JMarlin/nesii/(threads)

Thread 14 (2024-07-19):

[NES II] Add disk read timeout to bios

JMarlin, 2024-07-19:
## Description

As a user of the NES ][ it would be nice if the system were able to time out and drop to the monitor if there's no disk inserted

## Acceptance criteria

- [x] Sector read code sets a failure flag and exits in all the following cases rather than retrying forever
    - [x] Checksum mismatch
    - [x] Track mismatch
- [x] ~Sector read code includes a motor on and call to motor wait at entry which checks the return flag and uses it to fail exit early~
- [x] Motor wait call returns a failure flag and exits early in the following cases:
    - [x] Reading data latch never gets a high MSB after several reads
    - [x] Reading subsequent byte never changes after several reads
- [x] BIOS boot code retries boot sector load a couple of times and finally displays a message and drops into monitor
- [x] NOS boot is not broken
- [x] NOS DIR command is not broken
- [x] NOS RUN command is not broken
- [x] DONKEY is not broken

JMarlin, 2024-07-23:
Getting kind of frustrated with this, so here's the idea du jour: Forget the motor-on wait. Everywhere. Just base everything on retrying sector read

JMarlin, 2024-07-23:
Wrestling with flaky-ish hardware, but this looks like it's working properly now.
Got Mario to run with the current code which also handles the no-disk-at-boot condition properly, so it's functional.

I may want to add more retries to the binload routine in the future, though. And definitely will want to add proper failure handling to all of the fs and shell routines in the future.

Closed 2024-07-23.

Thread 22 (2024-07-26):

[NES II] Implement BIOS update module system

JMarlin, 2024-07-26:
## Description
In order to waste as little space as possible in our limited memory, I would like to harness the flexible memory mapping in the NES II cartridge to allow me to effectively add more system code to the BIOS area after boot in the form of binary overlays

## Acceptance criteria
- [x] PLD is updated to map high physical SRAM to low cart area in MODE 0 and map high physical SRAM to ROM area in MODE 2
- [x] BIOS immediately copies itself to high-RAM and then switches high-RAM into the BIOS area
- [x] ~~BIOS uses a flag in the ROM area to check whether it's already running out of RAM or not and not swap if it is~~
- [x] BIOS linking has been updated for efficiency so that it's not full of big useless holes
- [ ] DONKEY and MARIO loaders are updated to start in MODE 2 and switch to MODE 1 for second-half PRG load

JMarlin, 2024-07-26:
Important note: For some reason, it didn't occur to me that we still need to access the slot and switches when we're running the BIOS out of RAM. Figured out a hack wherein the high/low SRAM mapping is backwards from what it currently is between modes 0 and 2 and SRAM is selected in the ROM position in mode 2, but is otherwise the same. That way, when we start up in mode 0 we can copy the BIOS right into high physical SRAM and then switch into mode 2 running out of SRAM without really caring what physical portion of SRAM is mapped into the low cart area.

This is going to require some changes to both the PLD equations and the NES game loader code to work properly, which hasn't been implemented yet.

JMarlin, 2024-07-26:
Fixed up and tested the PLD to match the aforementioned scheme

JMarlin, 2024-07-26:
Note to myself about RAM availability: ostensibly, once we're in NOS, we can switch to one of the all-RAM modes and switch in and out of mode 2 when we need to do disk access. That should give us gobs of room for things like BASIC if we're going to end up wanting it.

Closed 2024-07-29.

Thread 23 (2024-07-26):

[NES II] Update SHELL to load any BIOS update modules found on the disk at startup

JMarlin, 2024-07-26:
## Description

For maximum flexibility and convenience, it would be nice to have update modules load themselves into the BIOS area simply by placing them on the disk. To that end, I would like the SHELL application to look through the catalog for update files and binary load each one before entering the command processor

## Acceptance criteria

- [ ] All bios update modules are loaded into the BIOS area when SHELL starts

JMarlin, 2024-08-07:
Making a note that I'm altering this radically. I've found that I can update the cart a little more to support RAM at 6000-7FFF and that obviates this whole module loading kerfuffle.

In the above commits, I've ended up moving the floppy space to E000, limiting the ROM to the FXXX area, and mapping the cart switches into that same FXXX space since they're write-only and the BIOS is read-only.

This gives me 8K (only 4K with the way I built the cart) of non-cart RAM that I can load NOS into, and also expands my non-game-mode cart RAM available for stuff like BASIC from 16K to 24K (now that the ROM+switches+floppy only occupy 8K of the cart area).

When it comes to BASIC, if I fix up the low RAM mapping so that I can use the full 8K then the extra nice thing is that in NESII mode I'll have an uninterrupted 32K of RAM stretching from 6000 to DFFF.

Actually, I could probably pretty trivially extend the non-cart RAM down to start at 5000 as well which would allow for 32K of RAM that can be FULLY dedicated to user purposes if I assume 4K of usage for NOS code

JMarlin, 2024-10-29:
After much heartache, I'm rolling back a bit here. The above approach just caused too many hardware headaches, so I'm moving back to the simpler method of compressing the address space (BIOS + switches @ 0xFXXX, slot @ 0xEXXX, RAM B @ 0xC000-0xDFFF)

I think I will keep the user module concept, and they will be loaded into the 0xC000-0xDFFF RAM.
As a note to myself, remember that the basic sector write code should be in the BIOS -- only the FS layer is in NOS (or, in the case of writes, TRON)

JMarlin, 2024-10-29:
And I should confirm that all hardware and software is tested and working as expected as of current main (commit f4df59a
)

JMarlin, 2025-02-28:
Back to it. The plan here is to once again provide an updatable BIOS situation.

At power-up, the BIOS should copy itself into $B000-$BFFF and then switch into 'swapped RAM' mode and continue execution. Swapped RAM mode should place what was at $Bxxx at $Fxxx (though still read-only).

When NOS starts up, it should swap back to 'original RAM' mode and then use the binloader to load any ".BUM" modules the normal way. These modules should be formatted to load into available slots in $Bxxx. Once all BUMs are loaded, NOS should switch back to 'swapped RAM' mode to lock in the BIOS changes.

BIOS changes can then include extended portions of NOS, such as the FS write implementation.

- [ ] RAM mapped read-only at $Fxxx in swapped-RAM mode
- [ ] BIOS copies itself into RAM at startup
- [ ] BIOS continues to execute from RAM
- [ ] NOS swaps RAM mapping, loads all BUMs, and swaps back at init

Thread 35 (2024-11-12):

[NES II] Select ROM only on CPU reads

JMarlin, 2024-11-12:
This is preparation for making writes to the same address space trigger the mode switches

JMarlin, 2024-11-12:
Tested against NOS and MARIO with no apparent regressions. Will really only know if this fully worked (short of hardware snooping) when I get into #36 so there's a full possibility of this getting reopened or an associated bug created.

Closed 2024-11-12.

Thread 37 (2024-11-12):

[NES II] Move slot select to $exxx address range

JMarlin, 2024-11-12:
Requires prior completion of #36 so that new slot location doesn't conflict with switches
Intent is to slide up the slot area to provide more room for cart RAM

JMarlin, 2024-11-15:
Making the steps explicit here:

- [ ] Update PLD to remap the slot location
- [ ] Update BIOS to remap the slot location
- [ ] Update NOS to remap the slot location
- [ ] Update MARIO to remap the slot location
- [ ] Update DONKEY to remap the slot location

JMarlin, 2024-11-15:
Updated everything and started testing -- looks like I probably have a bug somewhere because I'm back to getting that disk corruption again. Time to start debugging.

JMarlin, 2024-11-15:
As a note to self: Is there really a problem with stashing this issue for later and just moving forward with a memory map of 16k RAM, 4k slot, 8k RAM, 4k bios/switches? Jam BASIC and the floppy write routines in the high 8k and call it a day.

JMarlin, 2024-11-15:
Um. Hmm. Did a double-check on this after lunch and it's totally possible that I just forgot to copy the new NOS image to the ADT directory because I did that and wrote a new floppy and it looks like it works well.

JMarlin, 2024-11-15:
Whelp, NVM. Tried to launch DONKEY, but apparently the switches aren't working because after loading it booted right back into the BIOS.

Gonna need to give this a thorough clean-out and retry in the AM.

JMarlin, 2024-11-18:
Did some harnessing, and the switches aren't getting toggled. So I suppose that's good.
I think now I'll move on to setting breakpoints to debug NOS boot to try and figure out where it's going wrong.

JMarlin, 2024-11-18:
Ah. Right. The issue I saw last time is that the switches AREN'T working. Right.

JMarlin, 2024-11-20:
Weird day. Tried using an actual EEPROM in case it was that my emulator doesn't interact well with the switches. Tried increasing the monitor wait routine time just in case we were missing steps occasionally or something. Results were absolutely all over the place, so I think I need to take a bit step back.

I did pull the motherboard out of the NES with the aim of fully instrumenting it, which I think it's about time to do. Next session, I will instrument the whole thing, roll back to current master on NOS and the BIOS, and start really debugging step-by-step.

Note that I will definitely want to instrument the full data bus, the full address bus, the RWB line, the switch clock line, the switches, and the slot device select line. I think I can do all of those, and with those fully recorded I think I should be able to get clear insight into the operation of this thing.

JMarlin, 2024-12-02:
Creating bug #44 as a blocker on this item

JMarlin, 2025-01-25:
#44 has been closed by building a new card out of parts that haven't been reverse biased for tens of hours. Let's carry on.

JMarlin, 2025-01-28:
Unblocking, re-fixed #40 and confirmed MARIO is running again. Happy day. Now I HAVE to start back on this one.

JMarlin, 2025-01-28:
Closed with #46

Closed 2025-01-28.

Thread 40 (2024-11-12):

[NES II] Limit active ROM selection to $f000-$ffff

JMarlin, 2024-11-12:
This is an oversight from #34 -- the BIOS image was moved, but the hardware wasn't changed to limit the actual physical location at which the ROM is selected.

JMarlin, 2024-11-12:
Tested as very stable with NOS and MARIO, and confirmed with MON that data lines are floating in the $exxx region

JMarlin, 2025-01-28:
Reopening because current PLD code in master is allowing the ROM to always go onto the bus whenever we're in $Fxxx and thereby trample what we're trying to write to the switches.

Closed 2025-01-28.

Thread 44 (2024-12-02):

[NES II] BUG: NOS binary load duplicating adjacent bytes

JMarlin, 2024-12-02:
Blocker for implementing #37

I have begun debugging what's happening in NOS when we try to run with the floppy slot mapped at $exxx by inserting drop-into-monitor jumps
Thus far, I've been able to find that the call to `binary_loader_load` as NOS attempts to load SHELL is, for some reason, resulting in written content at $8000 matching the actual SHELL binary content -- with the exception that every odd byte is duplicated, overwriting the previous even byte

An example:
```
;Actual SHELL content
4C 04 80 00 AD F0 FF C9

;Data loaded at $8000
04 04 00 00 F0 F0 C9 C9
```

With further breakpointing, I have found that when `fs_read_file_byte` returns from its first invocation, the content of the sector buffer at $0400 looks perfectly correct. So it looks like some math is not mathing either within `fs_read_file_byte` or `binary_loader_load` when the slot is relocated for whatever bizarre reason

Purpose of this issue is to track my further investigation on this problem and document any solution

JMarlin, 2024-12-02:
Nope. Super weird. RAM address 0 is the same address 0 used throughout the board. And I'm not seeing any shorts to ground or similar

JMarlin, 2024-12-03:
Added an infinite "write $aa to $8000" loop so that I could view activity on the oscilloscope, and ended up finding that when I plug in the disk ii card the machine now totally refuses to start up. Considering I was also unable to determine a couple of days ago why the disk controller now suddenly doesn't work in my IIe, I think the card is *also* probably dead now, presumably from the same cause that the original NES died which I assume was latent effects of having the floppy power plugged in backwards.

I have a new controller card on order, but with the drive out of commission for the next week or so I guess I'll have to set aside hardware work to focus on software stuff that I can do in the emulator like working on the BASIC port.

Maybe I could work on finishing implementation of the apple pi floppy emulator while I wait, but odds are likely that I'd already have the new controller card in hand long before that was ever done. Still, it's a thought.

JMarlin, 2025-01-25:
Thank god. I did the smart thing and just straight-up built a new card. Works fine. Should have realized that hitting everything with bad power would fry many a part on board and I should have tossed them all. Oh well, feels good to be back in action.

As a note to myself, I'm not sure if the 16V8 that I'm using in the current board is one that might have gotten bad voltage. If I start having issues again, that would be the first place to check.

Alright! I can finally close this and get back to adjusting the memory mapping.

Closed 2025-01-25.

Thread 49 (2025-03-04):

[NES II] Improve keyboard routines

JMarlin, 2025-03-04:
Currently, there are two major issues that must be resolved with the keyboard code

- [ ] Improve 7/8 keys having trouble registering (maybe hardware)
- [ ] Stop keys multi-registering (needs debounce)
- [ ] Implement use of shift key to print special characters (needed for BASIC)
