JMarlin/nesii/hardware/pcb/NES_II/NES_II.kicad_pcb

## KiCad design hardware/pcb/NES_II/NES_II.kicad_pcb (2024-10-28)

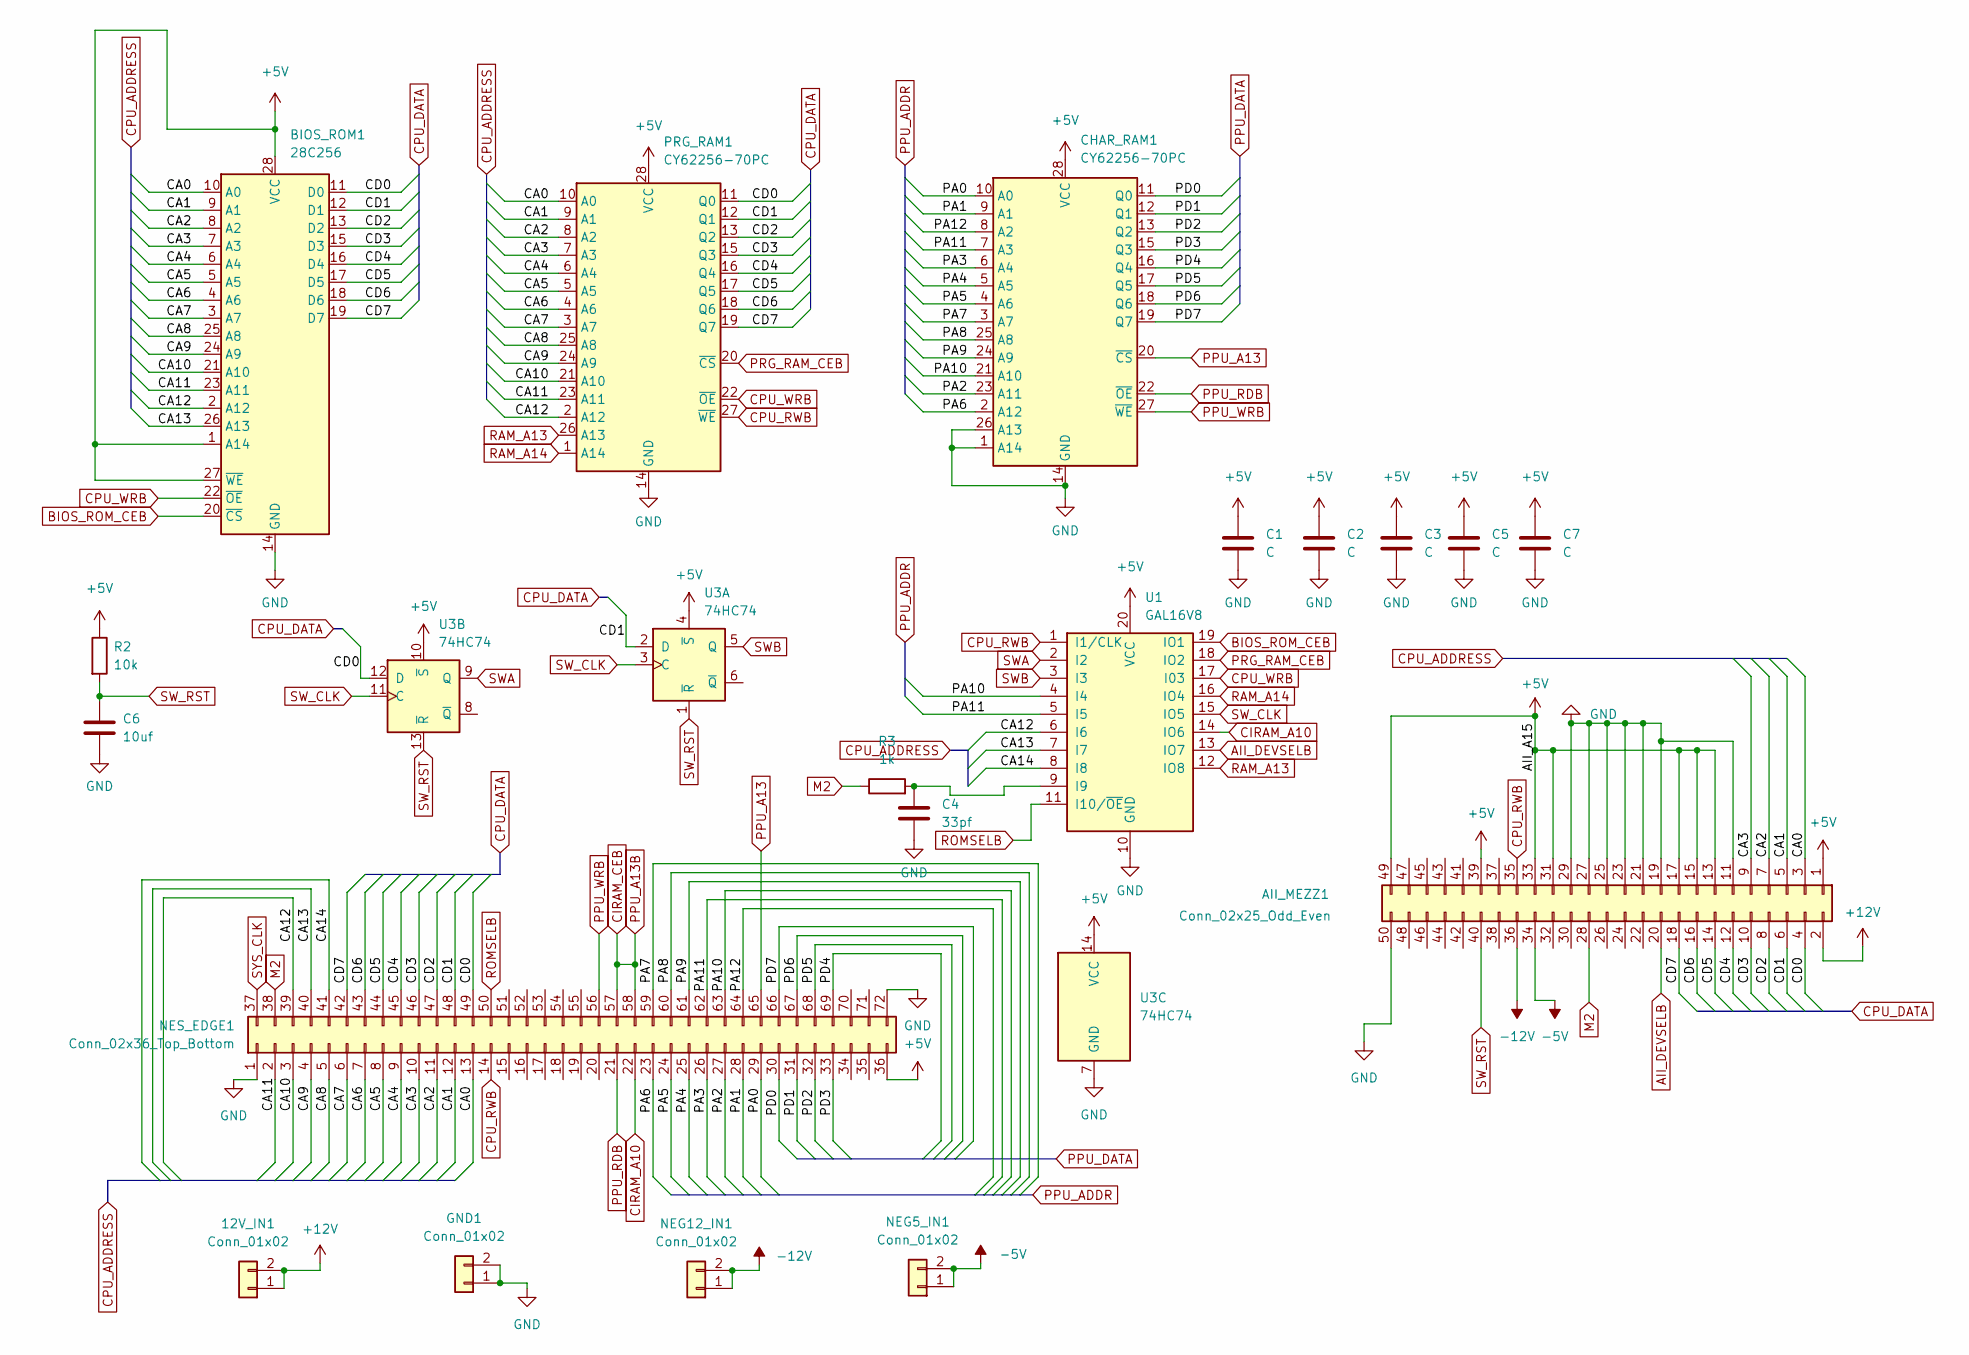
[picture p1: schematic NES_II.kicad_sch]

Parts:
12V_IN1: Conn_01x02; PinSocket_1x02_P2.54mm_Vertical
AII_MEZZ1: Conn_02x25_Odd_Even; PinSocket_2x25_P2.54mm_Vertical
BIOS_ROM1: 28C256; DIP-28_W15.24mm_Socket_LongPads
C1, C2, C3, C5, C7: C; CP_Radial_Tantal_D4.5mm_P2.50mm
C4: 33pf; CP_Radial_Tantal_D4.5mm_P2.50mm
C6: 10uf; C_Disc_D3.8mm_W2.6mm_P2.50mm
CHAR_RAM1: CY62256-70PC; DIP-28_W15.24mm_LongPads
GND1: Conn_01x02; PinSocket_1x02_P2.54mm_Vertical
NEG5_IN1, NEG12_IN1: Conn_01x02; PinSocket_1x02_P2.54mm_Vertical
NES_EDGE1: Conn_02x36_Top_Bottom; NES_CART
PRG_RAM1: CY62256-70PC; DIP-28_W15.24mm_LongPads
R2: 10k; R_Axial_DIN0204_L3.6mm_D1.6mm_P5.08mm_Vertical
R3: 1k; R_Axial_DIN0204_L3.6mm_D1.6mm_P5.08mm_Horizontal
U1: GAL16V8; DIP-20_W7.62mm_Socket_LongPads
U3: 74HC74; DIP-14_W7.62mm

Connections:
+5V: AII_MEZZ1.1, AII_MEZZ1.13, AII_MEZZ1.15, AII_MEZZ1.17, AII_MEZZ1.31, AII_MEZZ1.33, AII_MEZZ1.39, AII_MEZZ1.49, BIOS_ROM1.1 (A14), BIOS_ROM1.27 (~WE), BIOS_ROM1.28 (VCC), C1.1, C2.1, C3.1, C5.1, C7.1, CHAR_RAM1.28 (VCC), NES_EDGE1.36, PRG_RAM1.28 (VCC), R2.1, U1.20 (VCC), U3.4 (~S), U3.10 (~S), U3.14 (VCC)
+12V: 12V_IN1.1, 12V_IN1.2, AII_MEZZ1.2
-5V: AII_MEZZ1.34, NEG5_IN1.1, NEG5_IN1.2
-12V: AII_MEZZ1.36, NEG12_IN1.1, NEG12_IN1.2
/CA0: AII_MEZZ1.3, BIOS_ROM1.10 (A0), NES_EDGE1.13, PRG_RAM1.10 (A0)
/CA1: AII_MEZZ1.5, BIOS_ROM1.9 (A1), NES_EDGE1.12, PRG_RAM1.9 (A1)
/CA2: AII_MEZZ1.7, BIOS_ROM1.8 (A2), NES_EDGE1.11, PRG_RAM1.8 (A2)
/CA3: AII_MEZZ1.9, BIOS_ROM1.7 (A3), NES_EDGE1.10, PRG_RAM1.7 (A3)
/CA4: BIOS_ROM1.6 (A4), NES_EDGE1.9, PRG_RAM1.6 (A4)
/CA5: BIOS_ROM1.5 (A5), NES_EDGE1.8, PRG_RAM1.5 (A5)
/CA6: BIOS_ROM1.4 (A6), NES_EDGE1.7, PRG_RAM1.4 (A6)
/CA7: BIOS_ROM1.3 (A7), NES_EDGE1.6, PRG_RAM1.3 (A7)
/CA8: BIOS_ROM1.25 (A8), NES_EDGE1.5, PRG_RAM1.25 (A8)
/CA9: BIOS_ROM1.24 (A9), NES_EDGE1.4, PRG_RAM1.24 (A9)
/CA10: BIOS_ROM1.21 (A10), NES_EDGE1.3, PRG_RAM1.21 (A10)
/CA11: BIOS_ROM1.23 (A11), NES_EDGE1.2, PRG_RAM1.23 (A11)
/CA12: BIOS_ROM1.2 (A12), NES_EDGE1.39, PRG_RAM1.2 (A12), U1.6 (I6)
/CA13: BIOS_ROM1.26 (A13), NES_EDGE1.40, U1.7 (I7)
/CA14: NES_EDGE1.41, U1.8 (I8)
/CD0: AII_MEZZ1.4, BIOS_ROM1.11 (D0), NES_EDGE1.49, PRG_RAM1.11 (Q0), U3.12 (D)
/CD1: AII_MEZZ1.6, BIOS_ROM1.12 (D1), NES_EDGE1.48, PRG_RAM1.12 (Q1), U3.2 (D)
/CD2: AII_MEZZ1.8, BIOS_ROM1.13 (D2), NES_EDGE1.47, PRG_RAM1.13 (Q2)
/CD3: AII_MEZZ1.10, BIOS_ROM1.15 (D3), NES_EDGE1.46, PRG_RAM1.15 (Q3)
/CD4: AII_MEZZ1.12, BIOS_ROM1.16 (D4), NES_EDGE1.45, PRG_RAM1.16 (Q4)
/CD5: AII_MEZZ1.14, BIOS_ROM1.17 (D5), NES_EDGE1.44, PRG_RAM1.17 (Q5)
/CD6: AII_MEZZ1.16, BIOS_ROM1.18 (D6), NES_EDGE1.43, PRG_RAM1.18 (Q6)
/CD7: AII_MEZZ1.18, BIOS_ROM1.19 (D7), NES_EDGE1.42, PRG_RAM1.19 (Q7)
/PA0: CHAR_RAM1.10 (A0), NES_EDGE1.29
/PA1: CHAR_RAM1.9 (A1), NES_EDGE1.28
/PA2: CHAR_RAM1.23 (A11), NES_EDGE1.27
/PA3: CHAR_RAM1.6 (A4), NES_EDGE1.26
/PA4: CHAR_RAM1.5 (A5), NES_EDGE1.25
/PA5: CHAR_RAM1.4 (A6), NES_EDGE1.24
/PA6: CHAR_RAM1.2 (A12), NES_EDGE1.23
/PA7: CHAR_RAM1.3 (A7), NES_EDGE1.59
/PA8: CHAR_RAM1.25 (A8), NES_EDGE1.60
/PA9: CHAR_RAM1.24 (A9), NES_EDGE1.61
/PA10: CHAR_RAM1.21 (A10), NES_EDGE1.63, U1.4 (I4)
/PA11: CHAR_RAM1.7 (A3), NES_EDGE1.62, U1.5 (I5)
/PA12: CHAR_RAM1.8 (A2), NES_EDGE1.64
/PD0: CHAR_RAM1.11 (Q0), NES_EDGE1.30
/PD1: CHAR_RAM1.12 (Q1), NES_EDGE1.31
/PD2: CHAR_RAM1.13 (Q2), NES_EDGE1.32
/PD3: CHAR_RAM1.15 (Q3), NES_EDGE1.33
/PD4: CHAR_RAM1.16 (Q4), NES_EDGE1.69
/PD5: CHAR_RAM1.17 (Q5), NES_EDGE1.68
/PD6: CHAR_RAM1.18 (Q6), NES_EDGE1.67
/PD7: CHAR_RAM1.19 (Q7), NES_EDGE1.66
AII_DEVSELB: AII_MEZZ1.20, U1.13 (IO7)
BIOS_ROM_CEB: BIOS_ROM1.20 (~CS), U1.19 (IO1)
CIRAM_A10: NES_EDGE1.22, U1.14 (IO6)
CIRAM_CEB: NES_EDGE1.57, NES_EDGE1.58
CPU_RWB: AII_MEZZ1.35, NES_EDGE1.14, PRG_RAM1.27 (~WE), U1.1 (I1/CLK)
CPU_WRB: BIOS_ROM1.22 (~OE), PRG_RAM1.22 (~OE), U1.17 (I03)
GND: AII_MEZZ1.11, AII_MEZZ1.19, AII_MEZZ1.21, AII_MEZZ1.23, AII_MEZZ1.25, AII_MEZZ1.27, AII_MEZZ1.29, AII_MEZZ1.50, BIOS_ROM1.14 (GND), C1.2, C2.2, C3.2, C4.2, C5.2, C6.2, C7.2, CHAR_RAM1.1 (A14), CHAR_RAM1.14 (GND), CHAR_RAM1.26 (A13), GND1.1, GND1.2, NES_EDGE1.1, NES_EDGE1.72, PRG_RAM1.14 (GND), U1.10 (GND), U3.7 (GND)
M2: AII_MEZZ1.28, NES_EDGE1.38, R3.1
unnamed: C4.1, R3.2, U1.9 (I9)
PPU_A13: CHAR_RAM1.20 (~CS), NES_EDGE1.65
PPU_RDB: CHAR_RAM1.22 (~OE), NES_EDGE1.21
PPU_WRB: CHAR_RAM1.27 (~WE), NES_EDGE1.56
PRG_RAM_CEB: PRG_RAM1.20 (~CS), U1.18 (IO2)
RAM_A13: PRG_RAM1.26 (A13), U1.12 (IO8)
RAM_A14: PRG_RAM1.1 (A14), U1.16 (IO4)
ROMSELB: NES_EDGE1.50, U1.11 (I10/~OE)
SWA: U1.2 (I2), U3.9 (Q)
SWB: U1.3 (I3), U3.5 (Q)
SW_CLK: U1.15 (IO5), U3.3 (C), U3.11 (C)
SW_RST: AII_MEZZ1.40, C6.1, R2.2, U3.1 (~R), U3.13 (~R)
SYS_CLK: NES_EDGE1.37

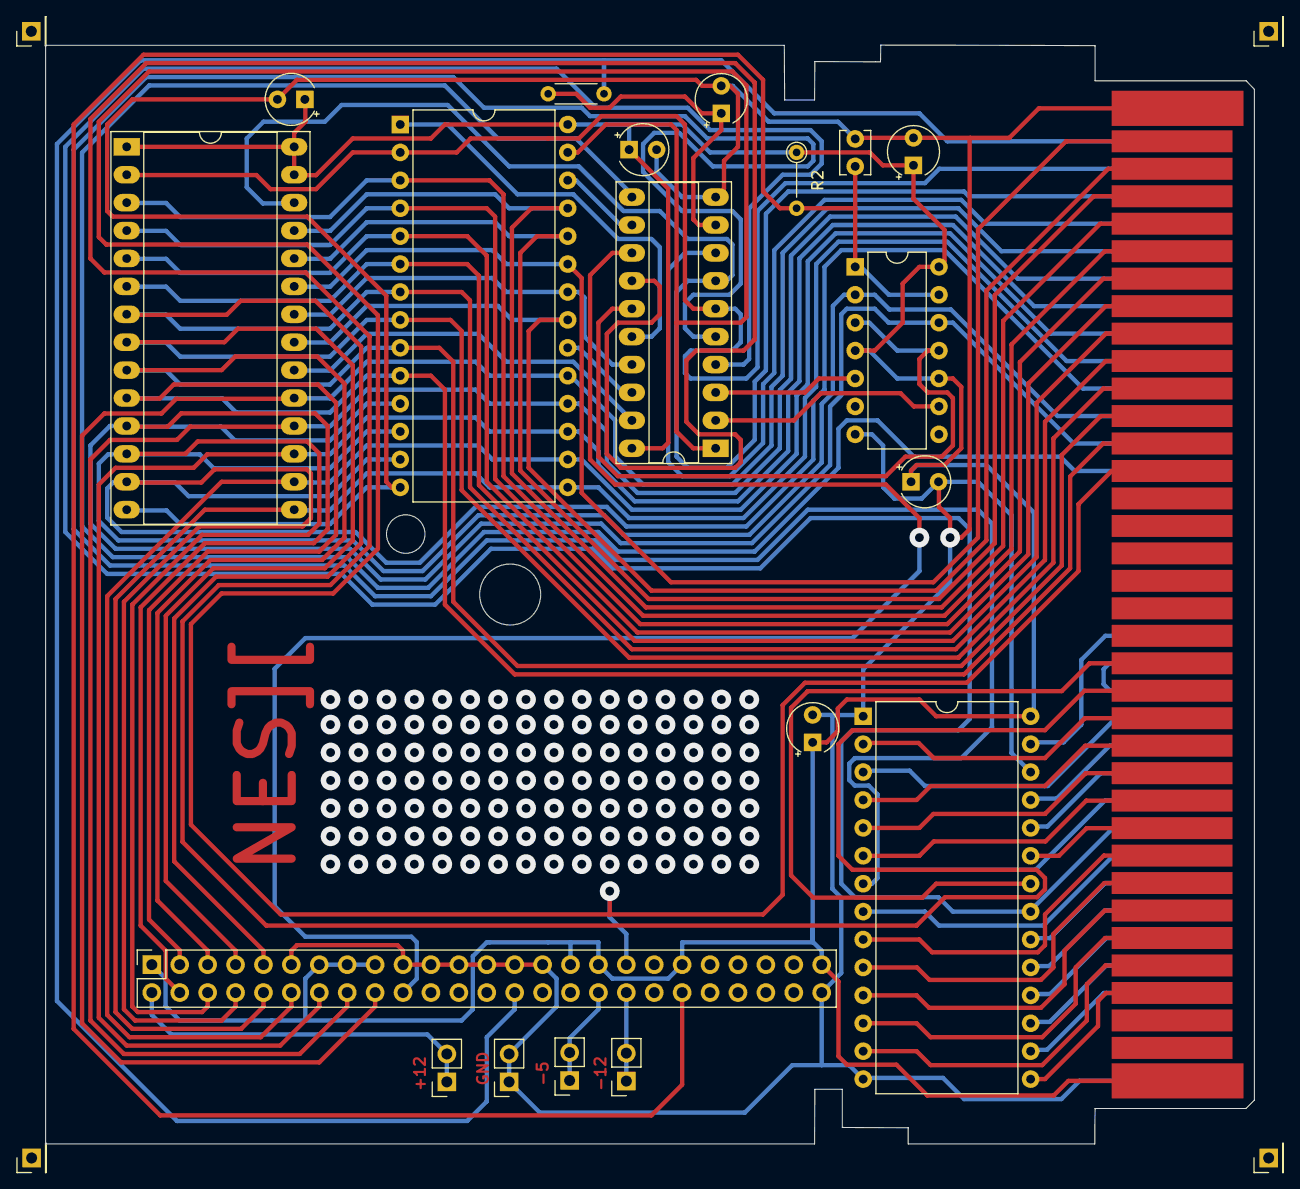
[picture p2: board NES_II.kicad_pcb from above]

Board: 2 copper layers, 110.0 x 100.0 mm, 20 parts (0 on the bottom side), 68 nets.
