JMarlin/nesii/(commit log)

2023-09-08 Friday the 8th before VCF @3:15 AM
    [ramlink.cfg]
2024-06-19 #1 fix line feed
    [char_io.asm]
2024-06-20 #3 code successfully halts after disk insertion with a loop checking for an address field
2024-06-20 #3 added Woz ROM track + sector read code, seems to give sane values after early exit
2024-06-21 #4 -ish, updated ROM and boot disk code to print some dope-ass messages
2024-06-25 New mapper confirmed working with floppy drive and sram low area swapping
    [bios.asm, char_io.asm]
2024-06-26 Working on track seeking in 16k PRG load code, currently able to load from track 0 through track 1 but not on to track 2
2024-06-27 Starting work on NOS
    [nos_link.cfg]
2024-06-28 Added a basic framework for a NOS boot image
    [nos_link.cfg]
2024-06-29 Basic command processor framework now working properly
2024-06-30 Reorganized NOS into its own directory; Split functional units into their own source files; Implemented enough of the DIR command to seek to and load the VTOC sector
    [nos_link.cfg]
2024-07-01 Fixed disk off after dir command done. Also started trying to implement seek in both directions, which does not currently appear to work
    [dir_command.asm, floppy.asm]
2024-07-02 Doing a test replacing actual floppy seeking with debug printing. Currently bizarrely does many steps in one direction, then many in the other, and then hangs
2024-07-03 #5 fixed arbitrary back/forth seek functionality, should be able to start reading catalog chain now
    [dir_command.asm, floppy.asm]
2024-07-03 #5 roughly printing all catalog entries now. Output needs cleanup
2024-07-03 #5 fixed up file name printing starting at wrong offset, still need to figure out why some blank entries are getting printed
    [dir_command.asm]
2024-07-03 #5 moved vertical margin printing outside of catalog chain loop
2024-07-06 #7 (because apparently this is actually issue 7, whoops) reorganized the code so that NOS can be compiled into the ROM for rapid development purposes
    [nosrom_link.cfg]
2024-07-08 #7 added stub for implementing run command and fs file lookup, cleaned up nos sources
    [nos_link.cfg]
2024-07-08 #7 finally implemented a prints macro
2024-07-10 #7 implemented print of bin file load address and size, also moved print hex routine out of floppy code and fixed it up
    [floppy.asm]
2024-07-12 #7 made sure floppy motor is turned on when read byte needs to grab a fresh sector
2024-07-17 #7 updated fs sector chain reading, moved floppy conversion table into ROM, testing loading of large files and currently hanging when we get to the 7th data sector for some reason
2024-07-17 #7 found the issue with loading large files, was just another spurious drive turned off too early problem. Can now load a 16k file successfully
    [fs.asm]
2024-07-17 #7 fixed up a small bug in data sector buffer tracking, running binaries tested and confirmed working
    [fs.asm]
2024-07-17 #8 moved floppy.asm over to ROM; NOS and ROM build okay now, but have yet to be tested
    [nos_link.cfg]
2024-07-18 #8 boot sectors moved over to and now build successfully but are untested. Need to finish shell and create a makefile for generating the whole disk image.
    [nos_link.cfg, system.cfg]
2024-07-18 #8 shell application builds, now to assemble and test an actual disk
    [nos_link.cfg, shell.cfg]
2024-07-19 #8 solved binary loader issues in system.bin
    [command_processor.asm, fs.asm]
2024-07-19 #8 loading and running of mario from Apple DOS 3.3 bin files implemented and confirmed working
    [mario.cfg]
2024-07-19 Added dk for fun
    [donkey.cfg]
2024-07-20 Massive cleanup and reorg of source tree
    [AII_Mezzanine.kicad_pcb, AII_Mezzanine.kicad_sch, NES_II.kicad_pcb, NES_II.kicad_sch, link.cfg, nosrom_link.cfg, ramlink.cfg]
2024-07-20 #13 switched from timed wait on the motor to check for data latch change
2024-07-22 #14 motor on timeout implemented
2024-07-23 #14 stashing for the day, code is in absolute disarray. I can get the boot sector to load now, but I can't get it to fail even though it does in the emulator
    [bios.asm, floppy.asm, fs.asm]
2024-07-23 #14 fix try-forever in sector header scan by introducing an outer retry counter
    [bios.asm, floppy.asm]
2024-07-24 #16 display an error message if a NOS disk is booted in an Apple II
    [bios.asm, floppy_startup.asm]
2024-10-28 PCB revision 2
    [NES_II.kicad_pcb, NES_II.kicad_sch]
2024-10-29 PLD switches swapped
2024-11-12 #32 fix non-immediate counter load (#33)
    [command_processor.asm]
2024-11-12 #34 move bios up to - range (#39)
    [link.cfg]
2024-11-14 #36 hardware and software updated to support write-only switches at (#43)
2025-01-28 Successfully implemented and tested slot addressing with MARIO and DONKEY (#46)
2025-02-06 Initial NESII BASIC implementation (#48)
    * add msbasic sources
    * Removed unnecessary files, added makefile, prepped config file updated memory map
    * Created a makefile
    * Figured out the bug with the all-zeroes screen, now need to figure out why we're looping at the memory size input
    * got as far as the terminal size prompt, but it's currently going right back to memory size prompt after
    * Add echo to character input
    * #27 update ines header blob with proper mapper number
    * #27 joojed BASIC load location and RAM base, confirmed working and ready for next steps
    ---------
    [nesii.cfg]
